ashwink0819/esp32-gesture-recognizer/docs/feature_explorer.png

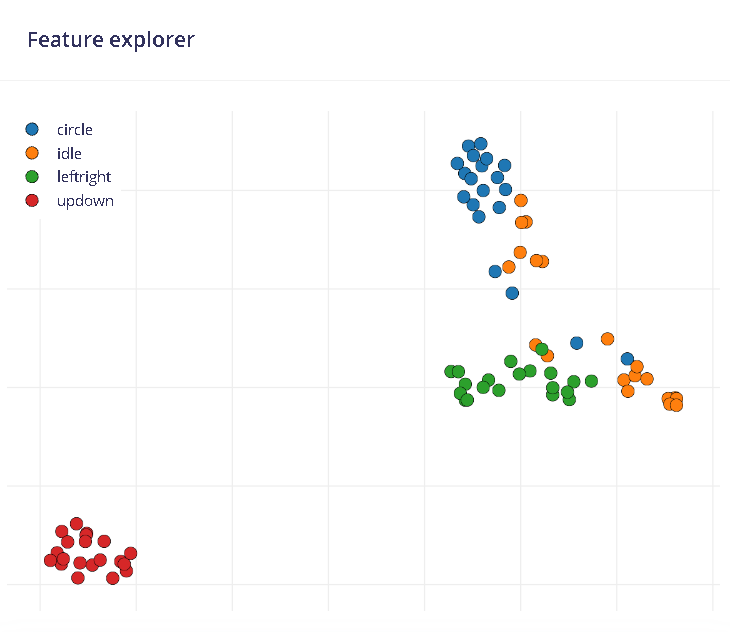
docs/feature_explorer.png
