ashwink0819/esp32-gesture-recognizer/docs/wiring.png.png

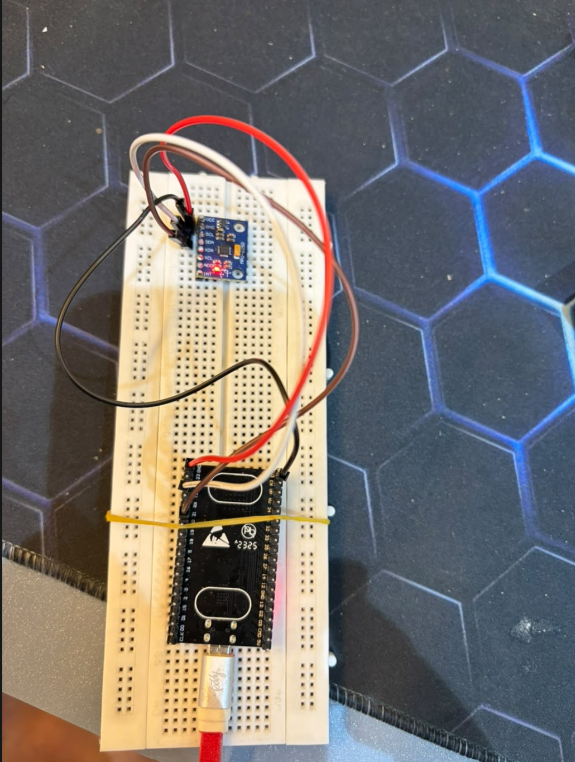
docs/wiring.png.png
