ashwink0819/esp32-gesture-recognizer/docs/confusion_matrix_test_v1.png

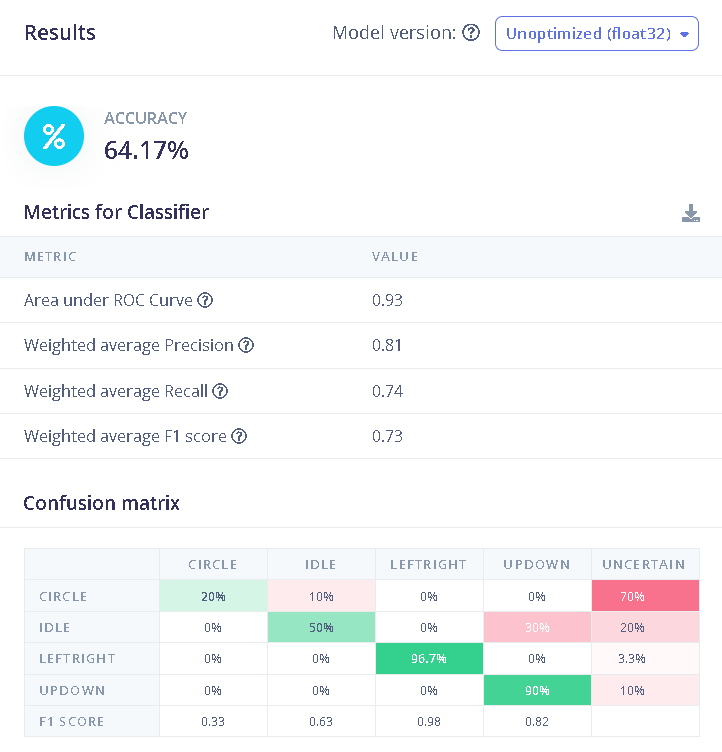
docs/confusion_matrix_test_v1.png
