ashwink0819/esp32-gesture-recognizer/docs/confusion_matrix_validation.png

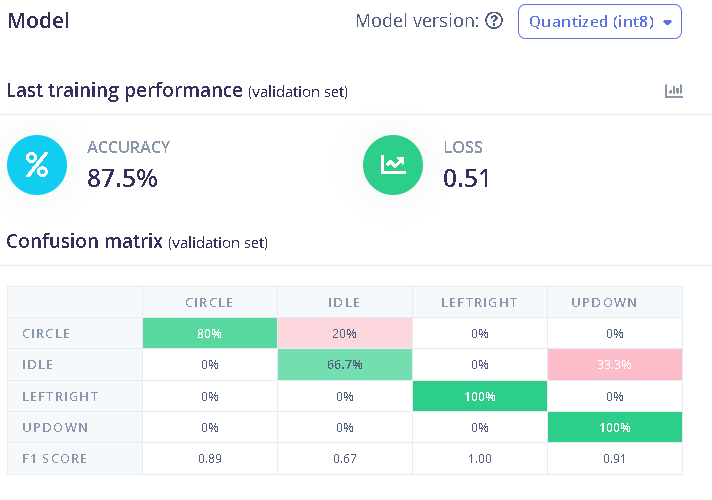
docs/confusion_matrix_validation.png
