ashwink0819/esp32-gesture-recognizer/(commit log)

2026-11-06 Create serial_test.ino
    Board bring-up: serial upload verified
2026-11-07 Toolchain ready: ESP32 core + Edge Impulse CLI
2026-11-11 On-device inference working
    - gesture_inference sketch: motion trigger, 0.6 s pre-buffer, 80% confidence threshold
    - capture.py data collection tool
    - Dataset: ashwin (train) + mom (test only)
    - Docs: feature explorer, confusion matrices v1-v3, circle comparison
    [circle.ashwin_000.csv, circle.ashwin_001.csv, circle.ashwin_002.csv, circle.ashwin_003.csv, circle.ashwin_004.csv, circle.ashwin_005.csv, circle.ashwin_006.csv, circle.ashwin_007.csv]
2026-11-12 Add README, wiring photo, final results
    - README with results, method, and "what failed and why"
    - On-device tally: circle 6/10, updown 5/10, leftright 10/10, 2/10 idle false triggers
    - Wiring photo
2026-11-12 wiring photo removed
